Jowllel/Wireless-ScoreBoard/2_Documentation/Spec/WSB_Communication_Specification/Premable.tex

\usepackage[left=2cm, right=2cm, bottom=3cm, top=3cm]{geometry}
\usepackage[onehalfspacing]{setspace}
\usepackage{graphicx} % Used to insert images
\usepackage{float} %Package for using the [H] option on graphics to force them into place
\usepackage{enumerate} % Needed for markdown enumerations to work
\usepackage{url}
\usepackage{hyperref}
\usepackage[nohyperlinks]{acronym}
\usepackage{graphicx}
\usepackage{fancyhdr}
\usepackage[]{xcolor}
\usepackage{footnote}
\usepackage{tikz}
\usepackage{pgfplots}
\usepackage{todonotes}
\usepackage{lipsum}

\usepackage[english]{babel}  % Für Deutsche Rechtschreibung (LM)
\usepackage{amsmath} % Math-Package (LM)
\usepackage{hologo} % for TeX engine logos
\usepackage{booktabs} % for nice tables
\usepackage{array} 
\usepackage{amssymb}

\usepackage{makecell}
\usepackage{tablefootnote}

\bibliographystyle{ieeetr}

\pgfplotsset{compat=1.18}

\setlength{\marginparwidth}{2cm}

% ============= No massive space betweend headline and chapter titel =============
\renewcommand*{\chapterheadstartvskip}{\vspace*{-.4cm}}
\renewcommand*{\chapterheadendvskip}{\vspace{.5cm}}

\setlength{\parindent}{0pt} % no indent at paragraph start

% ============= Header and Footer =============
\fancypagestyle{icmt-fancy}
{
  \fancyhf{}% Clear header and footer
  \fancyhead[L]{\AbbreviatedTitle}
  \fancyhead[R]{\Author}
  \fancyfoot[L]{\Date}
  \fancyfoot[C]{\Publisher}
  \fancyfoot[R]{\thepage}% Custom footer *~|~\pageref{LastPage}
  \renewcommand{\headrulewidth}{0.4pt}% Line at the header visible
  \renewcommand{\footrulewidth}{0.4pt}% Line at the footer visible
}
\renewcommand*{\chapterpagestyle}{icmt-fancy}

% ============= Size of headings =============
\setkomafont{chapter}{\LARGE}
\setkomafont{section}{\Large}
\setkomafont{subsection}{\large}
\setkomafont{subsubsection}{\normalsize}
\setkomafont{paragraph}{\normalsize}
\setkomafont{subparagraph}{\small}
