Jowllel/Wireless-ScoreBoard/2_Documentation/Documentation_Wireless_ScoreBoard_Remote/Acronym.tex

\begin{acronym}
        \acro{WSB}[WSB]{The Name of the Wireless ScoreBoard I'm developing.}
        \acro{hw}[HW]{Hardware}
        \acro{sw}[SW]{Software}
        \acro{fw}[FW]{Firmware}
        \acro{spi}[SPI]{Serial Peripheral Interface (low level protocol)}
        \acro{hal}[HAL]{Hardware Abstraction Layer (STM32 Abstraction Library)}
        \acro{ethz}[ETHZ]{Eidgenössische Technische Hochschule}
        \acro{tbz}[TBZ]{Technische Berufsschule Zürich}
        \acro{adc}[ADC]{Analog Digital Converter (STM32 unit)}
        \acro{tim}[TIM]{Timer (STM32 unit)}
        \acro{dut}[DUT]{Device under test}
        \acro{rcc}[RCC]{Reset and Clock Control (STM32 unit)}
        \acro{msp}[MSP]{Main Stack Pointer}
        \acro{awg}[AWG]{Arbitrary Waveform Generator}
\end{acronym}
