Jowllel/Wireless-ScoreBoard/2_Documentation/Documentation_Wireless_ScoreBoard_Remote/Frontpage.tex

\newgeometry{left=2cm,right=2cm,bottom=1.2cm,top=2.1cm}
\pagestyle{empty}

\begin{tikzpicture}[remember picture, overlay]
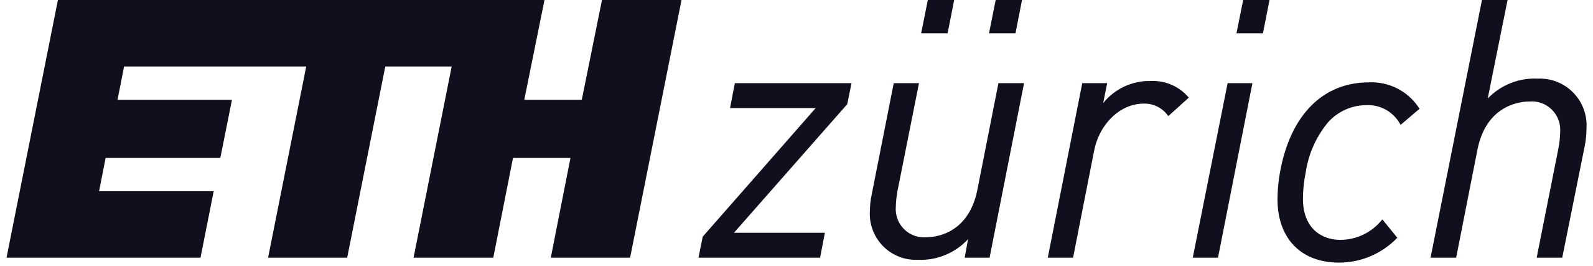
[picture p1: 2_Documentation/Documentation_Wireless_ScoreBoard_Remote/Resources/logoImage.png]
\node[anchor=north west, inner sep=0pt] at (-1cm, 1.6cm) {};
\end{tikzpicture}

\begin{center}

\vspace{-0.7cm}
\Huge{{{\fontsize{24}{30} \textbf{\sffamily{\Title}}\\}}}
\vspace{-0.2cm}
\LARGE{{{\fontsize{16}{24} \textbf{\sffamily{\Subtitle}}\\}}}
\vfill

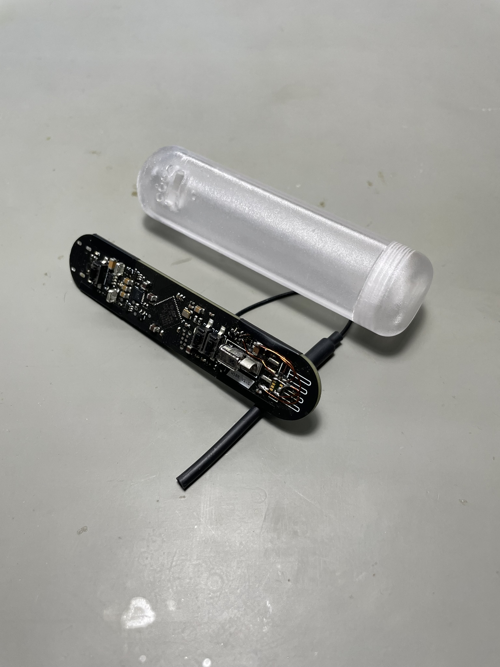
[picture p2: 2_Documentation/Documentation_Wireless_ScoreBoard_Remote/Resources/IMG_1446.JPEG]

\vfill

\large
Submitted by:\\
\fontsize{15pt}{15pt}\selectfont
\textbf{\sffamily{\Author}} \\
\fontsize{11pt}{15pt}\selectfont
\vspace{0.4cm}

\normalsize{Advisor: \Advisor}

\normalsize{\Date\space(\Version)}

\end{center}

\restoregeometry
