Jowllel/Wireless-ScoreBoard/2_Documentation/Documentation_Wireless_ScoreBoard_Remote/Settings.tex

\def\Title{Wireless ScoreBoard Remote}
\def\Subtitle{vocational school project}

\def\Author{Joel Schaller}
\def\Publisher{ETHZ / TBZ}

\def\Advisor{Enrico Malacarne}

\def\Date{05.07.2024}
\def\Version{V1.0}
