Jowllel/Wireless-ScoreBoard/2_Documentation/Documentation_Wireless_ScoreBoard_Remote/Chapters/Appendix_B.tex

\chapter{Appendix B}
\label{cha:Appendix B}

\section{HW Concept}
\label{sec:HW Concept}
\begin{figure}[H]
	\centering
        \framebox{
	}
	\caption{HW Concept}
	\label{fig:HW Concept}
\end{figure}

\section{Remote Schematics}
\label{sec:Schematics}
\begin{figure}[H]
	\centering
	
	\caption{Remote Schematics}
	\label{fig:Remote Schematics}
\end{figure}
\newpage

\section{Remote BOM}
\label{sec:Remote BOM}
\begin{figure}[H]
	\centering
        \framebox{
	}
	\caption{Remote BOM}
	\label{fig:Remote BOM}
\end{figure}
\newpage

\section{PCB Drawings}
\label{sec:PCB Drawings}
\begin{figure}[H]
\begin{subfigure}{0.24\textwidth}
\framebox{
}
\caption{PCB top}
\end{subfigure}
\begin{subfigure}{0.24\textwidth}
\framebox{
}
\caption{Assembly top}
\end{subfigure}
\begin{subfigure}{0.24\textwidth}
\framebox{
}
\caption{PCB bottom}
\end{subfigure}
\begin{subfigure}{0.24\textwidth}
\framebox{
}
\caption{Assembly bottom}
\end{subfigure}
\caption{PCB Drawings}
\label{fig:PCB Drawings}
\end{figure}
\newpage

\section{Communication Specification}
\label{sec:Communication Specification}
\begin{figure}[H]
	\centering
        \framebox{
	}
	\caption{Communication Specification}
	\label{fig:Communication Specification}
\end{figure}
