Jowllel/Wireless-ScoreBoard/2_Documentation/Documentation_Wireless_ScoreBoard/Chapters/Appendix.tex

\chapter{Appendix}
\label{cha:Appendix}

\section{Journal}
\label{sec:Journal}

\begin{table}[H]
    \centering
    
\begin{tabular}{||c | c | c || c||} 
 \hline
 Date &  Location & Duration & Activity \\ [0.5ex] 
 \hline\hline
    30.01.2024 & HOME & 2h & Set up GitHub repo and documentation \\   
 \hline
    01.02.2024 & HOME & 0.5h & First draft of project agreement [\ref{sec:Project Agreement}] \\ 
 \hline
    17.02.2024 & HOME & 3h & Acc test as counter trigger [\ref{sec:Trigger}] \\ 
 \hline
    18.02.2024 & HOME & 0.5h & doc: acc test results [\ref{ssec:Accelerometer}] \\ 
 \hline
    18.02.2024 & HOME & 1h & battery charging: R\&D [\ref{sec:Battery Charging}] \\ 
 \hline
    18.02.2024 & HOME & 2h & HW Concept [\ref{sec:HW Concept}] \\ 
 \hline
    19.02.2024 & HOME & 2.5h & Started drawing SYM and FP for WSBR Schematic \\ 
 \hline
    23.02.2024 & TBZ & 0.5h & Signed Project Agreement [\ref{sec:Project Agreement}] \\ 
 \hline
    26.02.2024 & HOME & 1.5h & Project Mindmap [\ref{sec:Mindmap}] / GANTT [\ref{sec:GANTT}] \\ 
 \hline
    27.02.2024 & HOME & 0.5h & Bought LiPo battery / 2-week plan KW8 \& KW9 [\ref{ssec:KW8_KW9}] \\ 
 \hline
    28.02.2024 & HOME & 0.5h & Added some components to remote schematics [\ref{sec:Schematics}] \\ 
 \hline
    29.02.2024 & HOME & 1h & Added missing components \& Added missing datasheets \\ 
 \hline
    01.03.2024 & TBZ & 1h & Added missing components \& Added missing datasheets \\ 
 \hline
    01.03.2024 & HOME & 1.5h & "Pflichtenheft" \& Init ioc file \& Added missing comp. \\ 
 \hline
    02.03.2024 & HOME & 2h & MCU pinout \& Schem: MCU, SWD, USBC [\ref{sec:Schematics}] \\ 
 \hline
    03.03.2024 & HOME & 2h & Drawn power section schematics [\ref{sec:Schematics}] \\ 
 \hline
    04.03.2024 & HOME & 1h & Drawn: nRF, acc, LEDs, BTs [\ref{sec:Schematics}] \\ 
 \hline
    06.03.2024 & HOME & 2.5h & Completed schematics and self-review [\ref{sec:Schematics}] \\ 
 \hline

\end{tabular}
    \caption{Project Journal 1}
    \label{tab:Project Journal 1}
\end{table}

\newpage

\section{Project Agreement}
\label{sec:Project Agreement}
\begin{figure}[H]
	\centering
        \framebox{
	}
	\caption{Project Agreement}
	\label{fig:Project Agreement}
\end{figure}

\newpage

\section{GANTT}
\label{sec:GANTT}
\begin{figure}[H]
	\centering
        \framebox{
	}
	\caption{GANTT}
	\label{fig:GANTT}
\end{figure}

\section{2-week plans}
\label{sec:2-week plans}

\subsection{KW8 \& KW9}
\label{ssec:KW8_KW9}
\begin{itemize}
    \item Write and sign the project agreement.
    \item Add GANTT time planning diagram.
    \item Add project mindmap.
    \item Write "Pflichtenheft" and introduction.
    \item Draw all symbols and footprints for the remote PCB, that don't already exist in the Altium Vault.
    \item Maybe start with the schematics for the remote PCB.
    \begin{itemize}
        \item Microcontroller supply, SWD, Reset and misc. connections.
        \item Generate ioc file for microcontroller. (STM32Cube)
        \item Start with the power path schematics. (Battery, Battery Charger IC, Load Switch)
    \end{itemize}
\end{itemize}

\subsection{KW10 \& KW11}
\label{ssec:KW10_KW11}
\begin{itemize}
    \item Complete remote schematics.
    \begin{itemize}
        \item nRF24
        \item RGB LED
        \item accelerometer
        \item buttons
    \end{itemize}
    \item Prepare schematics and HW documentation for review.
    \item Ask Mr. Malacarne to review the remote schematics.
    \item Make the remote PCB layout.
    \item Start with the remote case prototype.
\end{itemize}

\subsection{KW12 \& KW13}
\label{ssec:KW12_KW13}
\begin{itemize}
    \item 
\end{itemize}

\subsection{KW14 \& KW15}
\label{ssec:KW14_KW15}
\begin{itemize}
    \item 
\end{itemize}

\subsection{KW16 \& KW17}
\label{ssec:KW16_KW17}
\begin{itemize}
    \item 
\end{itemize}

\subsection{KW18 \& KW19}
\label{ssec:KW18_KW19}
Holiday / language study trip Malta.

\subsection{KW20 \& KW21}
\label{ssec:KW20_KW21}
\begin{itemize}
    \item 
\end{itemize}

\subsection{KW22 \& KW23}
\label{ssec:KW22_KW23}
\begin{itemize}
    \item 
\end{itemize}

\subsection{KW24 \& KW25}
\label{ssec:KW24_KW25}
\begin{itemize}
    \item 
\end{itemize}
