Jowllel/Wireless-ScoreBoard/3_Presentation/WSB_Presentation_jschaller.pptx

## Wireless Scoreboard

Remote

By Joel Schaller

Notes: Welcome

## Table of contents 01 03 02 04

Demonstration

Hardware

Introduction to the Scoreboard

Remote PCB and Case.

Conclusion

What I’ve learned and further improvements

Next steps to completion

Outlook

PCB = Printed Circuit Board

## Demonstration 01

Introduction to the Scoreboard

Notes: Say what the project was supposed to do and demonstrate what it does at the moment.
Start Up
Stop
Charge
Pass the WSBR around

## Hardware 02

Remote PCB and Case.

PCB = Printed Circuit Board

## Slide 5

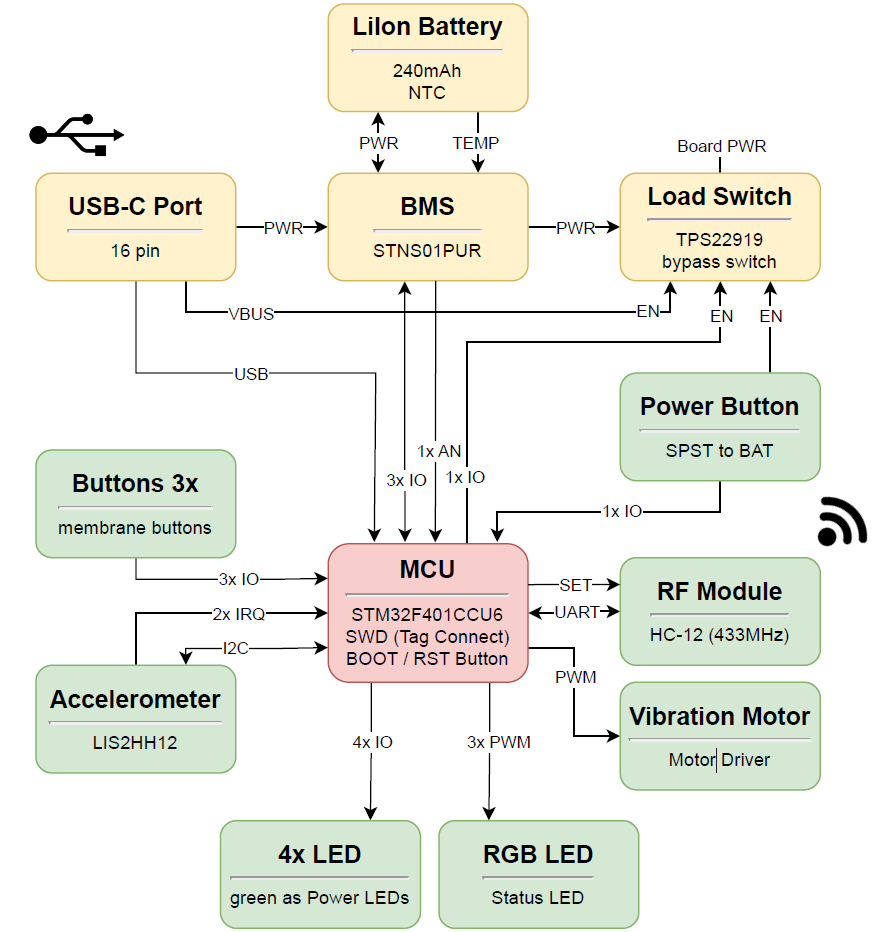
[picture p11: figure]

## Slide 6

## Slide 7

## Slide 8

## Slide 9

## Conclusion 03

What I’ve learned and further improvements

## Conclusion

PROs:
- Optimized HW Design workflow
- Low Power Application.
- Battery management.
CONs:
- To small Accelerometer (small deadbug)
- Planned to much
- Displays doesn‘t work by now.

HW = Hardware

## Outlook 04

Next steps to completion

Notes: FW Completion WSBR
Tap detection.
Haptic Feedback implementation

Display:
ePaper make work
Design case

## Thanks!
