Jowllel/Wireless-ScoreBoard/2_Documentation/GANTT/GANTT.pdf

# GANTT - WSB Remote

Plan Duration | % Complete

Calendar Week
8 | 9 | 10 | 11 | 12 | 13 | 14 | 15 | 16 | 17 | 18 | 19 | 20 | 21 | 22 | 23 | 24 | 25
Project planning and misc. 8 2 9 1 100% management

Generate Symbols and Footprints for PCB 9 1 8 2 100%

Schematics for PCB 9 2 9 3 100%

Layout for PCB 11 1 11 1 100%

Case Prototype for Remote 11 2 12 3 100%

PCB finalization & order 12 1 13 1 100%

PCB assembly & commissioning 14 1 15 1 100%

case finalization and order 15 1 20 1 100%

nRF24 test and abstraction (obsolete) 13 1 0 0 0%

LIS2HH12 abstraction 16 1 22 1 100%

test acceleromter as counter trigger 16 5 0 0 0%

Firmware finalization 17 5 23 2 100%

finalize documentation 22 3 25 1 100%

prepare presentation PP 23 2 24 1 100%

self rating 24 1 25 1 100%

Hand in 25 1 25 1 100%

Documentation (Main Body, Journal) 8 17 8 17 100%

2-week plans 8 17 9 17 100%

First milestone meeting 14 1 14 1 100%

Second milestone meeting 21 1 21 1 100%

Actual Start | Actual (beyond plan) | % Complete (beyond plan)

PERCENT

COMPLETE ACTIVITY | PLAN
START

PLAN
DURATION

ACTUAL
START

ACTUAL
DURATION | Schulferien
