Jowllel/Wireless-ScoreBoard/2_Documentation/Documentation_Wireless_ScoreBoard_Remote/Resources/titleImage.png

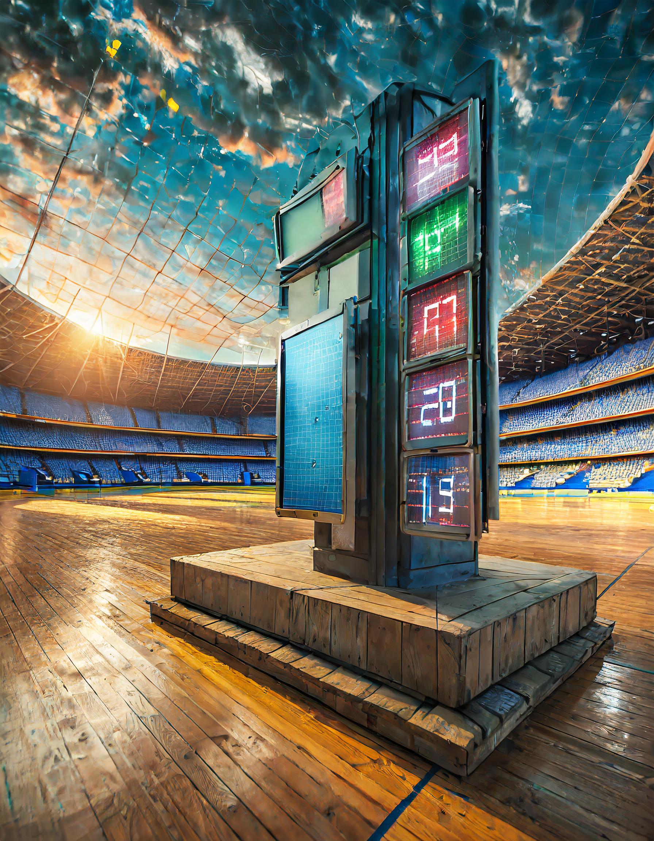
2_Documentation/Documentation_Wireless_ScoreBoard_Remote/Resources/titleImage.png
