Jowllel/Wireless-ScoreBoard/4_Resources/MG001V.png

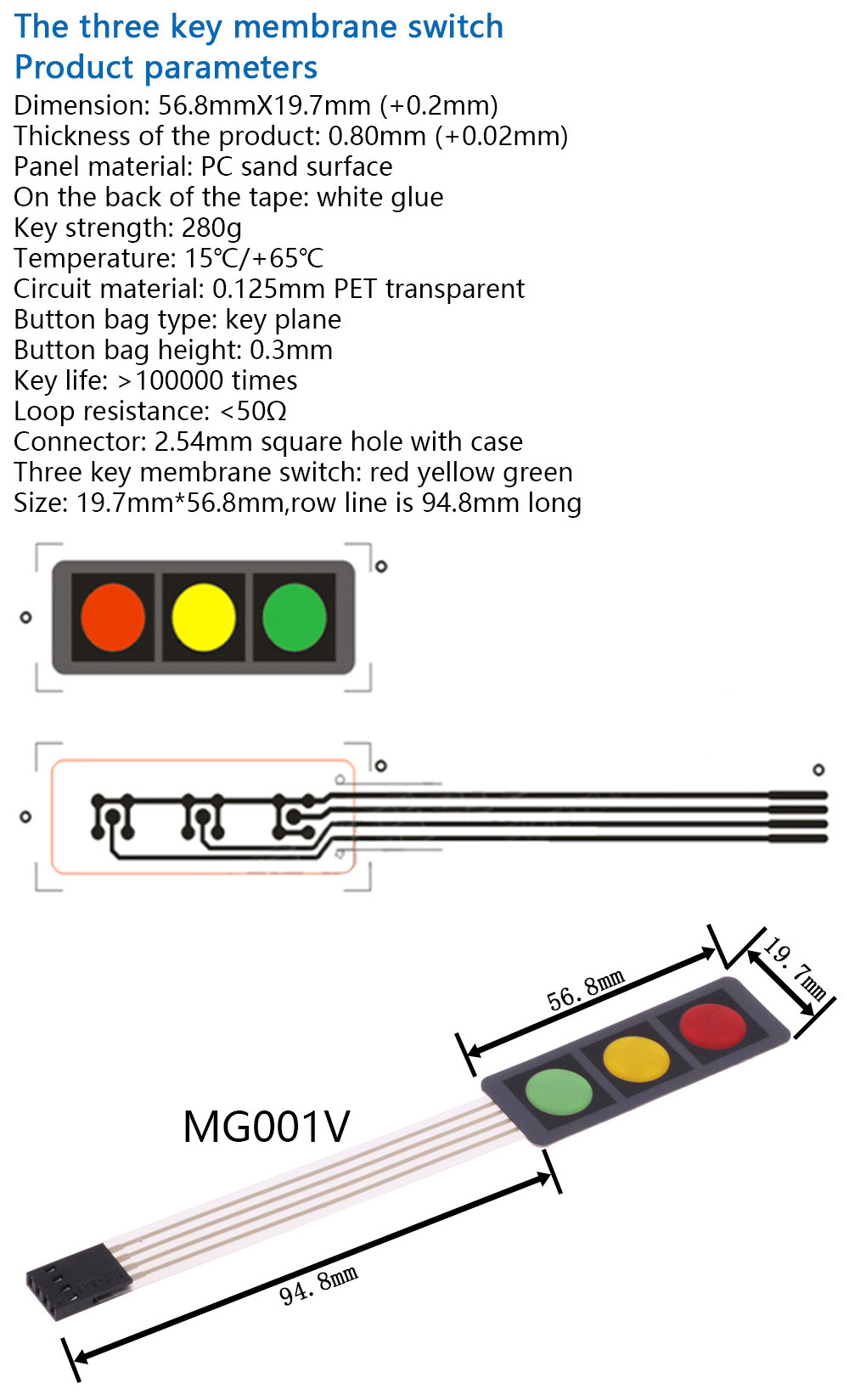
4_Resources/MG001V.png
