Jowllel/Wireless-ScoreBoard/4_Resources/NRF24L01_SMD_Module.png

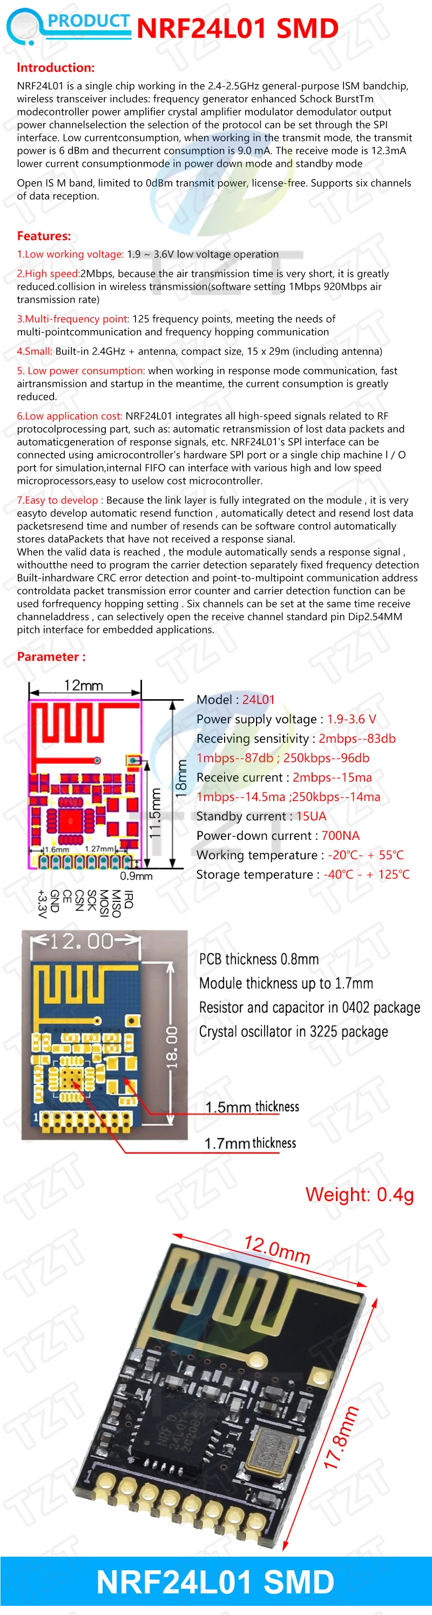
4_Resources/NRF24L01_SMD_Module.png
