Jowllel/Wireless-ScoreBoard/5_Hardware/WSBR_Case/Case_Lid_V1_0.stl

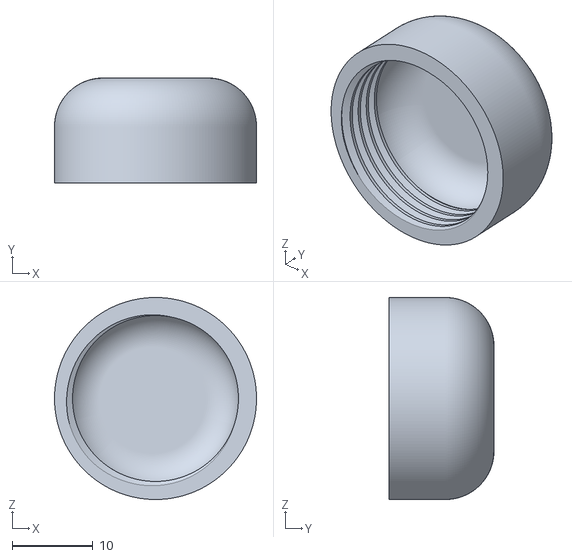
[picture p15: CAD file, 2024-05-22]
5_Hardware/WSBR_Case/Case_Lid_V1_0.stl
25.0 x 13.0 x 25.0
