Jowllel/Wireless-ScoreBoard/5_Hardware/WSBR_Case/Case_Body_V1_0.stl

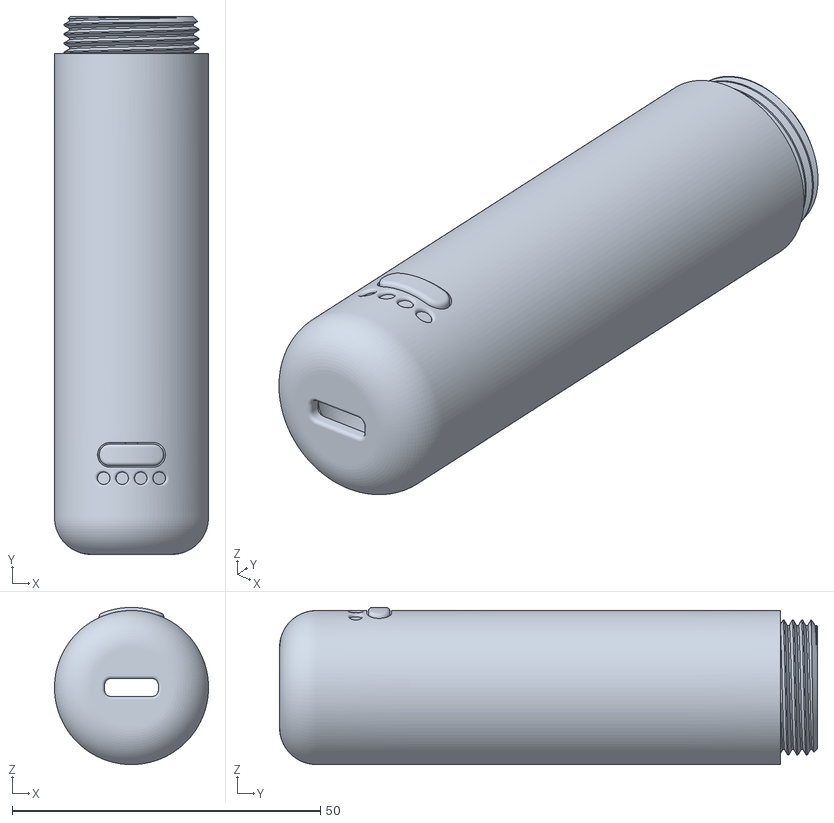
[picture p16: CAD file, 2024-05-22]
5_Hardware/WSBR_Case/Case_Body_V1_0.stl
25.0 x 87.3 x 25.5
