Jowllel/Wireless-ScoreBoard/5_Hardware/WSBR_Board/Project Outputs for WSBR_Board/PCB 3D Print BOT/WSBR_Board.png

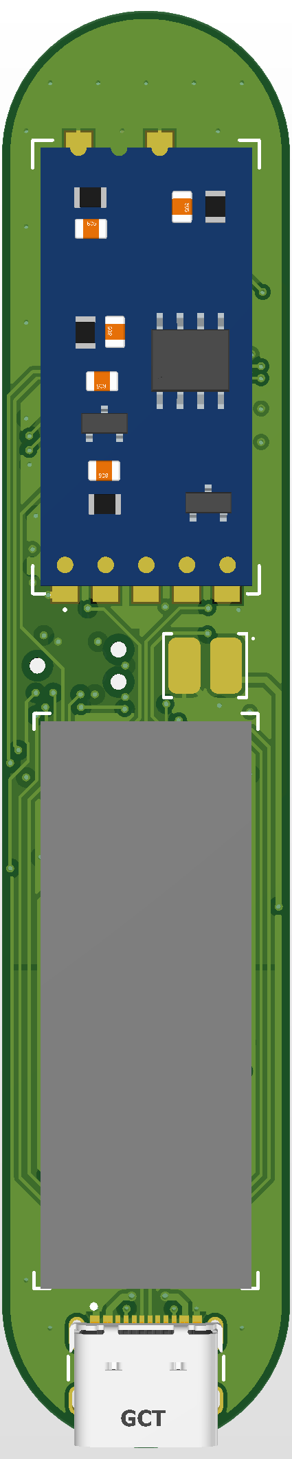
5_Hardware/WSBR_Board/Project Outputs for WSBR_Board/PCB 3D Print BOT/WSBR_Board.png
