Jowllel/Wireless-ScoreBoard/2_Documentation/HW_Concept/HW_Concept_WSB_Remote.drawio.pdf

## Hardware Concept WSBR Board

## LiIon Battery

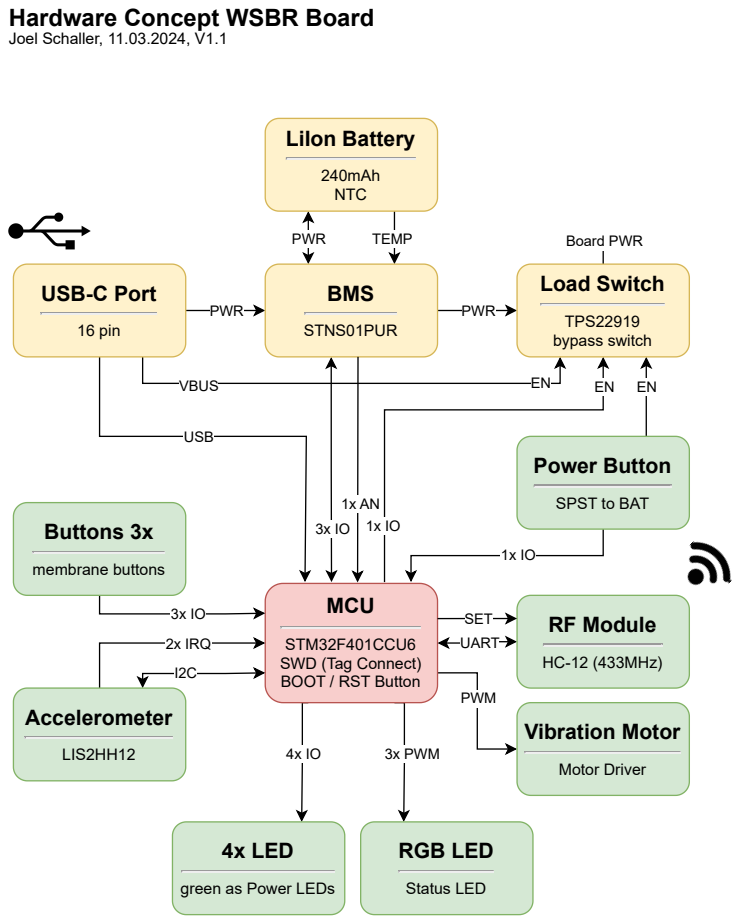
[picture p19: page 1]
Joel Schaller, 11.03.2024, V1.1; 3x PWM; PWM; MCU; UART; RF Module; HC-12 (433MHz); Buttons 3x; membrane buttons; 2x IRQ; Accelerometer; LIS2HH12; Power Button; 4x LED; RGB LED; Status LED; PWR; TEMP; 240mAh NTC; USB; VBUS; USB-C Port; 16 pin; BMS; STNS01PUR; Board PWR; Load Switch; TPS22919 bypass switch; SET; Vibration Motor; Motor Driver

SPST to BAT

STM32F401CCU6
SWD (Tag Connect)
BOOT / RST Button

green as Power LEDs
