Jowllel/Wireless-ScoreBoard/(list of files, drawings)

Other design files:
5_Hardware/WSBR_Board/Overview.SchDoc
5_Hardware/WSBR_Board/WSBR_Board.PcbDoc
5_Hardware/WSBR_Board/WSBR_Board.PrjPcb
