Jowllel/Wireless-ScoreBoard/6_Software/Firmware_WSBR/Core/Inc/main.h

#define PWR_LED2_Pin GPIO_PIN_13
#define PWR_LED2_GPIO_Port GPIOC
#define PWR_LED1_Pin GPIO_PIN_14
#define PWR_LED1_GPIO_Port GPIOC
#define OSC_IN_Pin GPIO_PIN_0
#define OSC_IN_GPIO_Port GPIOH
#define NC1_Pin GPIO_PIN_1
#define NC1_GPIO_Port GPIOH
#define BMS_BATMS_Pin GPIO_PIN_0
#define BMS_BATMS_GPIO_Port GPIOA
#define BMS_SD_Pin GPIO_PIN_1
#define BMS_SD_GPIO_Port GPIOA
#define HC_TX_Pin GPIO_PIN_2
#define HC_TX_GPIO_Port GPIOA
#define HC_RX_Pin GPIO_PIN_3
#define HC_RX_GPIO_Port GPIOA
#define HC_SET_Pin GPIO_PIN_4
#define HC_SET_GPIO_Port GPIOA
#define BMS_CEN_Pin GPIO_PIN_5
#define BMS_CEN_GPIO_Port GPIOA
#define BMS_CHG_Pin GPIO_PIN_6
#define BMS_CHG_GPIO_Port GPIOA
#define LED_R_Pin GPIO_PIN_13
#define LED_R_GPIO_Port GPIOB
#define LED_G_Pin GPIO_PIN_14
#define LED_G_GPIO_Port GPIOB
#define LED_B_Pin GPIO_PIN_15
#define LED_B_GPIO_Port GPIOB
#define PWR_SW_Pin GPIO_PIN_9
#define PWR_SW_GPIO_Port GPIOA
#define PWR_EN_Pin GPIO_PIN_10
#define PWR_EN_GPIO_Port GPIOA
#define USB_N_Pin GPIO_PIN_11
#define USB_N_GPIO_Port GPIOA
#define USB_P_Pin GPIO_PIN_12
#define USB_P_GPIO_Port GPIOA
#define SW_DIO_Pin GPIO_PIN_13
#define SW_DIO_GPIO_Port GPIOA
#define SW_CLK_Pin GPIO_PIN_14
#define SW_CLK_GPIO_Port GPIOA
#define VIB_Pin GPIO_PIN_15
#define VIB_GPIO_Port GPIOA
#define SW_O_Pin GPIO_PIN_3
#define SW_O_GPIO_Port GPIOB
#define ACC_SCL_Pin GPIO_PIN_6
#define ACC_SCL_GPIO_Port GPIOB
#define ACC_SDA_Pin GPIO_PIN_7
#define ACC_SDA_GPIO_Port GPIOB
#define PWR_LED4_Pin GPIO_PIN_8
#define PWR_LED4_GPIO_Port GPIOB
#define PWR_LED3_Pin GPIO_PIN_9
#define PWR_LED3_GPIO_Port GPIOB
