Jowllel/Wireless-ScoreBoard/6_Software/Firmware_WSBR/Core/User/usermain.h

/**
 ******************************************************************************
 * @file        usermain.h
 * @author      jschaller
 * @date        25.04.2024
 * @version     1.0
 * @brief       main, that only contains user written code.
 ******************************************************************************
 */

#ifndef USER_USERMAIN_H_
#define USER_USERMAIN_H_

#include "main.h"

void usermain(void);

#endif /* USER_USERMAIN_H_ */
