Jowllel/Wireless-ScoreBoard/6_Software/Firmware_WSBR/Core/User/acc.h

/**
 ******************************************************************************
 * @file        acc.h
 * @author      jschaller
 * @date        25.04.2024
 * @version     1.0
 * @brief       all functions for the accelerometer to detect taps.
 ******************************************************************************
 */

#ifndef USER_ACC_H_
#define USER_ACC_H_

#include "main.h"

#endif /* USER_ACC_H_ */
