Jowllel/Wireless-ScoreBoard/6_Software/Firmware_WSBR/Core/User/hc12.h

/**
 ******************************************************************************
 * @file        hc12.h
 * @author      jschaller
 * @date        25.04.2024
 * @version     1.0
 * @brief       all functions for the HC12 wireless module.
 ******************************************************************************
 */

#ifndef USER_HC12_H_
#define USER_HC12_H_

#include "main.h"

#endif /* USER_HC12_H_ */
