Jowllel/Wireless-ScoreBoard/6_Software/dev/LSM303C_Test/Core/Src/main.c

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
/* Includes ------------------------------------------------------------------*/
#include "main.h"
#include "i2c.h"
#include "usart.h"
#include "gpio.h"

/* USER CODE BEGIN Includes */

#include <stdio.h>
#include <string.h>
#include <stdlib.h>

/* USER CODE END Includes */


/* USER CODE BEGIN PV */

extern I2C_HandleTypeDef hi2c1;
extern UART_HandleTypeDef huart2;

/* USER CODE END PV */

void SystemClock_Config(void);
/**
  * @brief  The application entry point.
  * @retval int
  */
int main(void)
{
  /* MCU Configuration--------------------------------------------------------*/

  /* Reset of all peripherals, Initializes the Flash interface and the Systick. */
  HAL_Init();

  /* Configure the system clock */
  SystemClock_Config();

  /* Initialize all configured peripherals */
  MX_GPIO_Init();
  MX_USART2_UART_Init();
  MX_I2C1_Init();
  /* USER CODE BEGIN 2 */

  uint8_t CTRL_REGx_A[8] = {0x20, 0x3F, 0x00, 0x00, 0x34, 0x00, 0x00, 0x00}; //init array

//  uint8_t STATUS_REG_A_reg = 0x27;
//  uint8_t STATUS_REG_A_val = 0x00;

  uint8_t OUT_X_reg = 0x28;
  int16_t OUT_X_val = 0x00;
  double accX = 0;

  uint8_t OUT_Y_reg = 0x2A;
  int16_t OUT_Y_val = 0x00;
  double accY = 0;

  uint8_t OUT_Z_reg = 0x2C;
  int16_t OUT_Z_val = 0x00;
  double accZ = 0;

  int16_t accActive = 0;
  int16_t accActiveOld = 0;

  int16_t accDelta = 0;

  uint8_t str[50] = "";

  HAL_I2C_Master_Transmit(&hi2c1, 0x3A, CTRL_REGx_A, sizeof(CTRL_REGx_A), HAL_MAX_DELAY);   //init

  /* USER CODE END 2 */

  /* Infinite loop */
  /* USER CODE BEGIN WHILE */
  while (1)
  {
      HAL_I2C_Master_Transmit(&hi2c1, 0x3A, &OUT_X_reg, 1, HAL_MAX_DELAY);
      HAL_I2C_Master_Receive(&hi2c1, 0x3A, (uint8_t *)&OUT_X_val, 2, HAL_MAX_DELAY);
      accX = OUT_X_val * 0.244; //[accX]mg = LSB * 0.244mg/LSB

      HAL_I2C_Master_Transmit(&hi2c1, 0x3A, &OUT_Y_reg, 1, HAL_MAX_DELAY);
      HAL_I2C_Master_Receive(&hi2c1, 0x3A, (uint8_t *)&OUT_Y_val, 2, HAL_MAX_DELAY);
      accY = OUT_Y_val * 0.244; //[accY]mg = LSB * 0.244mg/LSB

      HAL_I2C_Master_Transmit(&hi2c1, 0x3A, &OUT_Z_reg, 1, HAL_MAX_DELAY);
      HAL_I2C_Master_Receive(&hi2c1, 0x3A, (uint8_t *)&OUT_Z_val, 2, HAL_MAX_DELAY);
      accZ = OUT_Z_val * 0.244; //[accZ]mg = LSB * 0.244mg/LSB

      accActive = (int16_t)(accX+accY+accZ);

      accDelta = abs(accActive - accActiveOld);

      accActiveOld = accActive;

      sprintf((char *)str, "accX:%+07.1fmg, accY:%+07.1fmg, accZ:%+07.1fmg\r\n", accX, accY, accZ);
//      sprintf((char *)str, "%f\t%f\t%f\t%d\r\n", accX, accY, accZ, accActive);
//      sprintf((char *)str, "%d\t\r\n", accDelta);
      HAL_UART_Transmit(&huart2, str, strlen((char *)str), HAL_MAX_DELAY);

      HAL_Delay(20);

    /* USER CODE END WHILE */

    /* USER CODE BEGIN 3 */
  }
  /* USER CODE END 3 */
}

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
