Jowllel/Wireless-ScoreBoard/(commit log)

2024-02-18 doc: battery charging R&D
2024-02-19 doc: HW_Concept: Changed 3/4x Buttons to 3x Buttons.
2024-02-19 HW: WSBR: Started schematic and registered components
    [Overview.SchDoc, WSBR_Board.PcbDoc, WSBR_Board.PrjPcb]
2024-02-26 doc: GANTT drawn.
    [GANTT.xlsx]
2024-02-28 Added some components from ETHZ Vault.
    [Overview.SchDoc]
2024-02-29 Added missing components.
    [Overview.SchDoc, WSBR_Board.PcbDoc]
2024-02-29 Added missing datasheets using for PCB.
2024-03-01 Init STM32CubeIDE project
2024-03-02 Drawn MCU, SWD, OSC, RESET, USB Schematics.
    [Overview.SchDoc, WSBR_Board.PcbDoc, WSBR_Board.PrjPcb]
2024-03-02 renamed pins in ioc pinout according to schematics.
2024-03-03 Drawn power section.
    [Overview.SchDoc, WSBR_Board.PcbDoc, WSBR_Board.PrjPcb]
2024-03-04 GANTT updates.
    [GANTT.xlsx]
2024-03-04 Schematics done, except start button.
    [Overview.SchDoc, WSBR_Board.PcbDoc, WSBR_Board.PrjPcb]
2024-03-06 Done with remote schematics.
    [Bill of Materials-WSBR_Board(default).xlsx, Overview.SchDoc, WSBR_Board.PcbDoc, WSBR_Board.PrjPcb]
2024-03-06 Made self-review and corrected some faults, added some info.
    [Bill of Materials-WSBR_Board(default).xlsx, Overview.SchDoc, WSBR_Board.PcbDoc, WSBR_Board.PrjPcb]
2024-03-06 embedded remote schematics into appendix b.
2024-03-07 Journal updates, Schematic Battery management section
2024-03-07 Added debounce C's for S1 and S3.
    [Bill of Materials-WSBR_Board(default).xlsx, Overview.SchDoc, WSBR_Board.PcbDoc]
2024-03-07 WSBR Board V1.0 done with documentation and HW Concept.
2024-03-10 Added notes from remote PCB V1.0 review.
2024-03-11 Added HC-12 RF Module and Vibration motor.
2024-03-11 WSBR Board V1.0 -> V1.1
    [WSBR_Board.PrjPcb]
2024-03-12 Schematic changes according to review.
    [Bill of Materials-WSBR_Board(default).xlsx, Overview.SchDoc, WSBR_Board.PcbDoc, WSBR_Board.PrjPcb]
2024-03-12 Added missing component resources for WSBR Board V1.1.
2024-03-12 Changed ioc according to WSBR Board Schematics V1.1.
2024-03-12 Journal updates, Started with Vibration motor, Started with RF Module switch doc.
2024-03-13 PCB: General placement.
    [Overview.SchDoc, WSBR_Board.PrjPcb]
2024-03-14 layed out components (top half not done.)
    [Overview.SchDoc, WSBR_Board.PrjPcb]
2024-03-15 Journal updates, Vibration Motor, HC_12
2024-03-16 done with laying out all components.
    [Overview.SchDoc, WSBR_Board.PrjPcb]
2024-03-17 Layout 20 connections missing.
    [Overview.SchDoc]
2024-03-17 changes pinout according to WSBR Schematics V1.1.
2024-03-17 final commit WSBR Board V1.1.
    [Bill of Materials-WSBR_Board(default).xlsx, Bill of Materials-WSBR_Board.xlsx, Overview.SchDoc, WSBR_Board.PrjPcb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]
2024-03-17 Journal updates, Embedded PCB figures.
2024-03-17 added gerber hasl zip to gitignore.
2024-03-18 Added FET DS.
2024-03-23 Started WSBR Case prototype.
2024-03-30 wip wsbr case.
2024-04-02 GANTT updates. (KW 12 & 13)
    [GANTT.xlsx]
2024-04-11 Case started printing first prototype.
2024-04-12 Journal updates, Assembly part
2024-04-12 Case: Thread length decreased.
2024-04-13 2nd case prototype. (less thread length, usb-c wall thickness decreased, usb-c slot increased.)
2024-04-24 WSBR Case V1.0 ready to order.
    [Case_Body_V1_0.stl, Case_Lid_V1_0.stl]
2024-04-25 Added first functions to BMS. (bms_getBat..., bms_enPwr)
2024-07-04 updates GANTT.pdf
    [GANTT.xlsx]
