Jowllel/Wireless-ScoreBoard/(notices)

Notices in the files:
6_Software/dev/LSM303C_Test/Core/Src/main.c:
Copyright (c) 2024 STMicroelectronics.
All rights reserved.
This software is licensed under terms that can be found in the LICENSE file
